griffinross2/Neo-GPS/Hardware/SD_Card_Logger/sd_card_logger.kicad_pcb

## KiCad design Hardware/SD_Card_Logger/sd_card_logger.kicad_pcb (2026-05-09)

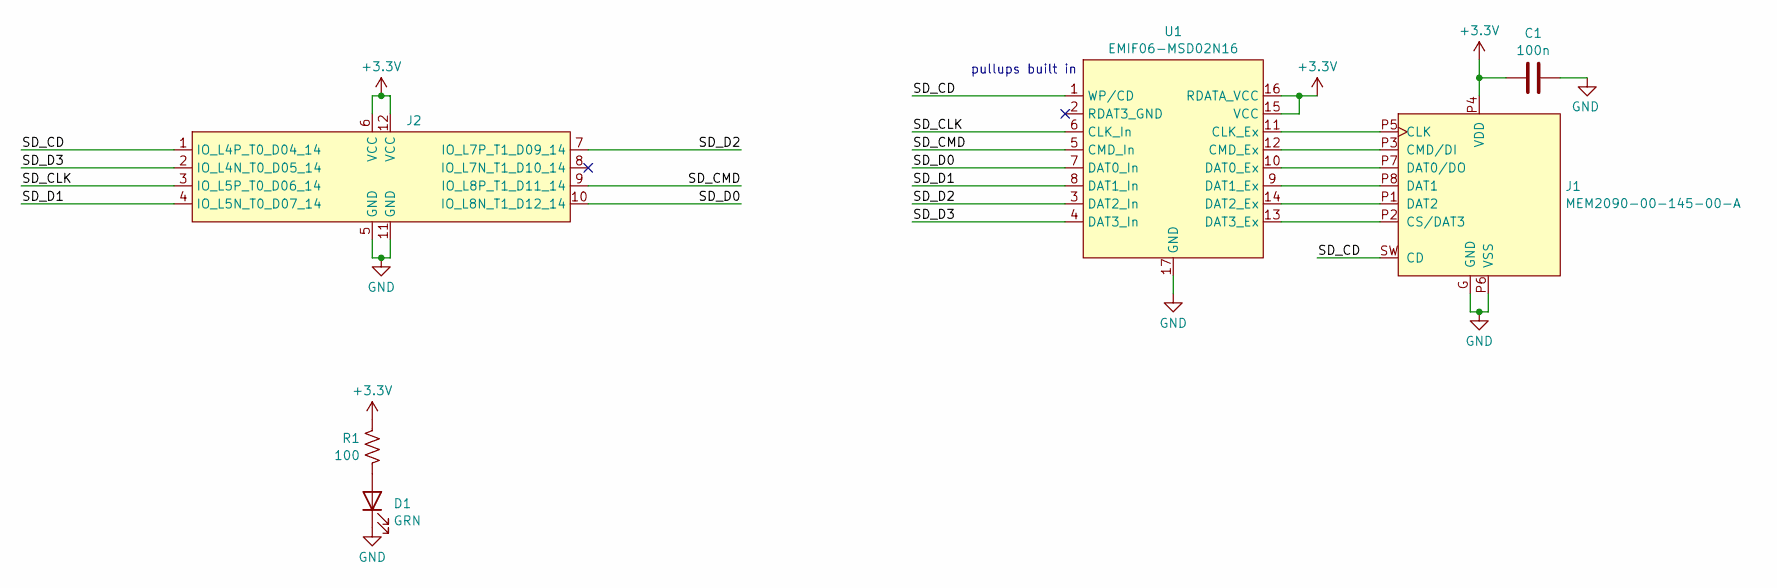
[picture p1: schematic sd_card_logger.kicad_sch]

Parts:
C1: 100n; C_0805_2012Metric; Manufacturer_Part_Number GCJ188R71H104KA12D
D1: GRN; LED_0805_2012Metric
J1: MEM2090-00-145-00-A; GCT_MEM2090-00-145-00-A_REVA; PARTREV A
J2: PinHeader_2x06_P2.54mm_Horizontal_Pmod
R1: 100; R_0805_2012Metric
U1: EMIF06-MSD02N16

Connections:
+3.3V: C1.1, J1.P4 (VDD), J2.6 (VCC), J2.12 (VCC), R1.1, U1.15 (VCC), U1.16 (RDATA_VCC)
/SD_CD: J1.SW (CD), J2.1 (IO_L4P_T0_D04_14), U1.1 (WP/CD)
/SD_CLK: J2.3 (IO_L5P_T0_D06_14), U1.6 (CLK_In)
/SD_CMD: J2.9 (IO_L8P_T1_D11_14), U1.5 (CMD_In)
/SD_D0: J2.10 (IO_L8N_T1_D12_14), U1.7 (DAT0_In)
/SD_D1: J2.4 (IO_L5N_T0_D07_14), U1.8 (DAT1_In)
/SD_D2: J2.7 (IO_L7P_T1_D09_14), U1.3 (DAT2_In)
/SD_D3: J2.2 (IO_L4N_T0_D05_14), U1.4 (DAT3_In)
GND: C1.2, D1.1 (K), J1.G (GND), J1.P6 (VSS), J2.5 (GND), J2.11 (GND), U1.17 (GND)
unnamed: D1.2 (A), R1.2
unnamed: J1.P5 (CLK), U1.11 (CLK_Ex)
unnamed: J1.P3 (CMD/DI), U1.12 (CMD_Ex)
unnamed: J1.P2 (CS/DAT3), U1.13 (DAT3_Ex)
unnamed: J1.P7 (DAT0/DO), U1.10 (DAT0_Ex)
unnamed: J1.P8 (DAT1), U1.9 (DAT1_Ex)
unnamed: J1.P1 (DAT2), U1.14 (DAT2_Ex)

Notes on the sheet:
pullups built in

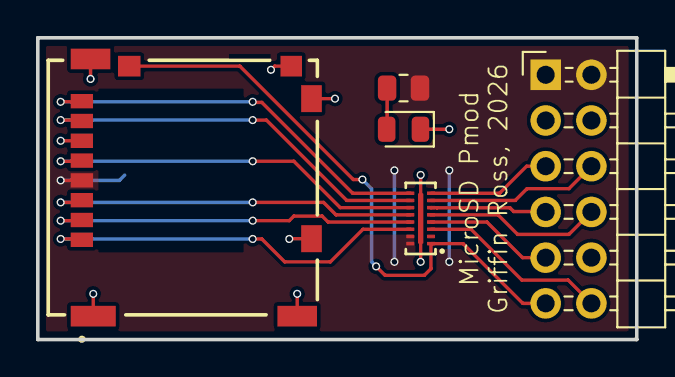
[picture p2: board sd_card_logger.kicad_pcb from above]

Board: 2 copper layers, 33.3 x 16.8 mm, 6 parts (1 on the bottom side), 16 nets.
