griffinross2/Neo-GPS/Hardware/GPS_Frontend/GPS_Frontend.kicad_pcb

## KiCad design Hardware/GPS_Frontend/GPS_Frontend.kicad_pcb (2026-05-03)

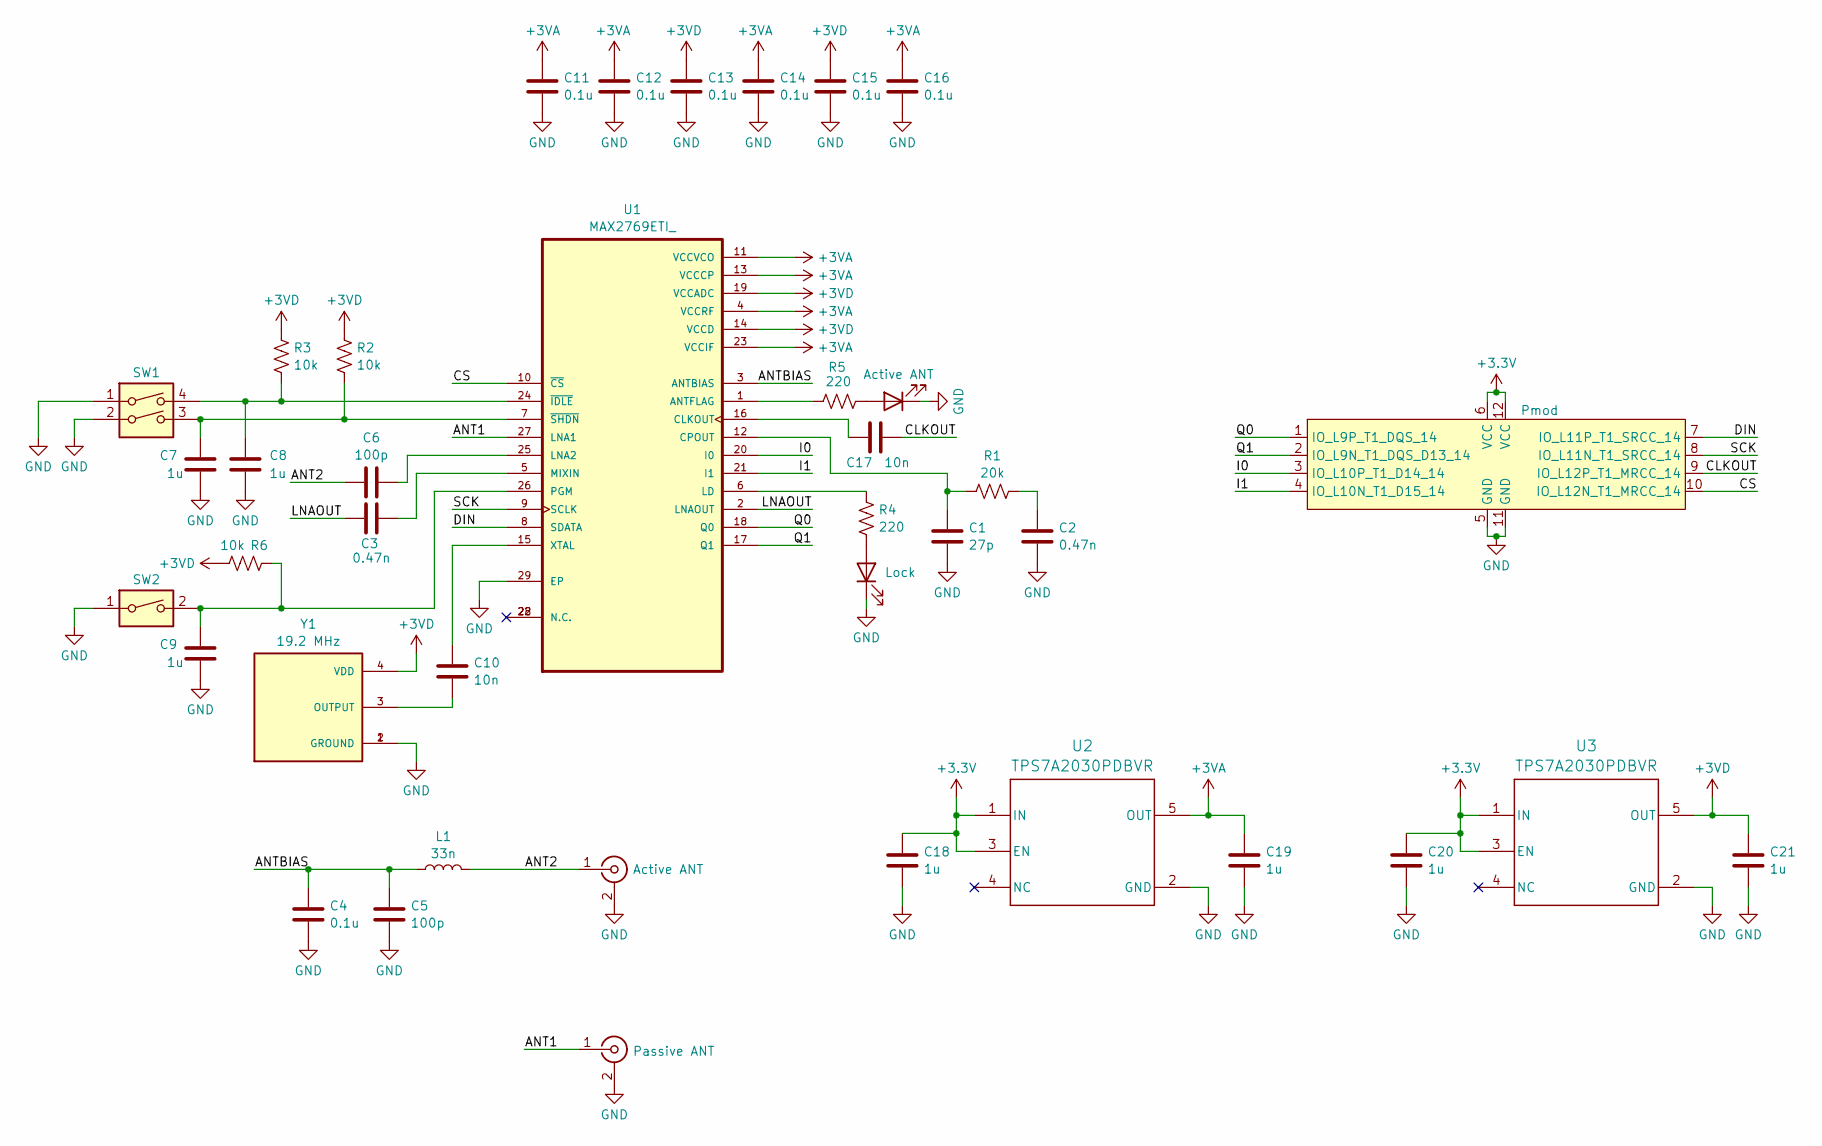
[picture p3: schematic GPS_Frontend.kicad_sch]

Parts:
C1: 27p; C_0402_1005Metric; Manufacturer_Part_Number GCM1555C1H270JA16J
C2, C3: 0.47n; C_0402_1005Metric; Manufacturer_Part_Number GCM1555C1H471JA16J
C4, C11, C12, C13, C14, C15, C16: 0.1u; C_0402_1005Metric; Manufacturer_Part_Number GRM155R61A104KA01J
C5, C6: 100p; C_0402_1005Metric; Manufacturer_Part_Number GRM1555C2A101GA01D
C7, C8, C9, C18, C19, C20, C21: 1u; C_0603_1608Metric; Manufacturer_Part_Number GRM188R61A105KA61J
C10, C17: 10n; C_0603_1608Metric; Manufacturer_Part_Number GCM188R72A103KA37D
J1: Pmod
J2: Passive ANT; SMA_Amphenol_132289_EdgeMount; Manufacturer_Part_Number 60312242114510
J3: Active ANT; SMA_Amphenol_132289_EdgeMount; Manufacturer_Part_Number 60312242114510
L1: 33n; L_0402_1005Metric; Manufacturer_Part_Number LQW15AN33NJ80D
LED1: Active ANT; LED_0805_2012Metric; Manufacturer_Part_Number 150080VS75000
LED2: Lock; LED_0805_2012Metric; Manufacturer_Part_Number 150080RS75000
R1: 20k; R_0603_1608Metric; Manufacturer_Part_Number RT0603FRE1020KL
R2, R3, R6: 10k; R_0603_1608Metric; Manufacturer_Part_Number RE0603FRE1310KL
R4, R5: 220; R_0603_1608Metric; Manufacturer_Part_Number RC0603JR-07220RP
SW1: SW_DIP_x02; SW_DIP_SPSTx02_Slide_6.7x6.64mm_W8.61mm_P2.54mm_LowProfile; Manufacturer_Part_Number A6S-2104-H
SW2: SW_DIP_x01; SW_DIP_SPSTx01_Slide_6.7x4.1mm_W8.61mm_P2.54mm_LowProfile; Manufacturer_Part_Number A6S-1104-H
U1: MAX2769ETI_; QFN50P500X500X80-29N
U2, U3: TPS7A2030PDBVR; DBV0005A-IPC_A
Y1: 19.2 MHz; OSC_ECS-TXO-20CSMV4-192-AN-TR; PARTREV N/A

Connections:
+3.3V: C18.1, C20.1, J1.6 (VCC), J1.12 (VCC), U2.1 (IN), U2.3 (EN), U3.1 (IN), U3.3 (EN)
+3VA: C11.1, C12.1, C14.1, C16.1, C19.1, U1.4 (VCCRF), U1.11 (VCCVCO), U1.13 (VCCCP), U1.23 (VCCIF), U2.5 (OUT)
+3VD: C13.1, C15.1, C21.1, R2.1, R3.1, R6.1, U1.14 (VCCD), U1.19 (VCCADC), U3.5 (OUT), Y1.4 (VDD)
/ANT1: J2.1 (In), U1.27 (LNA1)
/ANT2: C6.1, J3.1 (In), L1.2
/ANTBIAS: C4.1, C5.1, L1.1, U1.3 (ANTBIAS)
/CLKOUT: C17.2, J1.9 (IO_L12P_T1_MRCC_14)
/CS: J1.10 (IO_L12N_T1_MRCC_14), U1.10 (~CS)
/DIN: J1.7 (IO_L11P_T1_SRCC_14), U1.8 (SDATA)
/I0: J1.3 (IO_L10P_T1_D14_14), U1.20 (I0)
/I1: J1.4 (IO_L10N_T1_D15_14), U1.21 (I1)
/LNAOUT: C3.1, U1.2 (LNAOUT)
/Q0: J1.1 (IO_L9P_T1_DQS_14), U1.18 (Q0)
/Q1: J1.2 (IO_L9N_T1_DQS_D13_14), U1.17 (Q1)
/SCK: J1.8 (IO_L11N_T1_SRCC_14), U1.9 (SCLK)
GND: C1.2, C2.2, C4.2, C5.2, C7.2, C8.2, C9.2, C11.2, C12.2, C13.2, C14.2, C15.2, C16.2, C18.2, C19.2, C20.2, C21.2, J1.5 (GND), J1.11 (GND), J2.2 (Ext), J3.2 (Ext), LED1.1 (K), LED2.1 (K), SW1.1, SW1.2, SW2.1, U1.29 (EP), U2.2 (GND), U3.2 (GND), Y1.1 (GROUND), Y1.2 (GROUND)
unnamed: C2.1, R1.2
unnamed: LED1.2 (A), R5.1
unnamed: LED2.2 (A), R4.1
unnamed: R5.2, U1.1 (ANTFLAG)
unnamed: C17.1, U1.16 (CLKOUT)
unnamed: C1.1, R1.1, U1.12 (CPOUT)
unnamed: R4.2, U1.6 (LD)
unnamed: C6.2, U1.25 (LNA2)
unnamed: C3.2, U1.5 (MIXIN)
unnamed: C9.1, R6.2, SW2.2, U1.26 (PGM)
unnamed: C10.1, U1.15 (XTAL)
unnamed: C8.1, R3.2, SW1.4, U1.24 (~IDLE)
unnamed: C7.1, R2.2, SW1.3, U1.7 (~SHDN)
unnamed: C10.2, Y1.3 (OUTPUT)

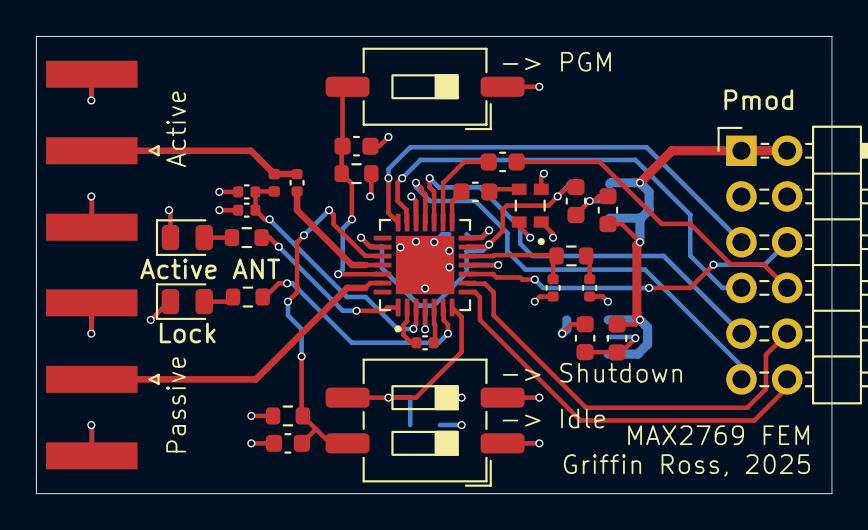
[picture p4: board GPS_Frontend.kicad_pcb from above]

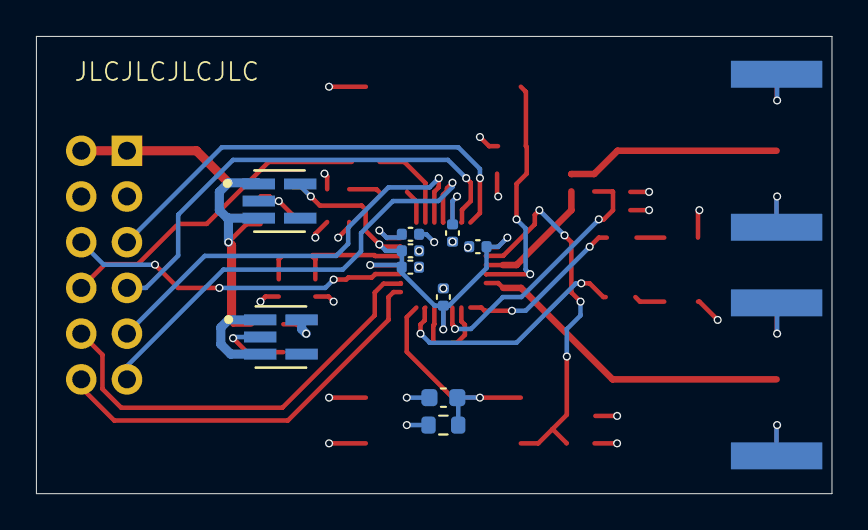
[picture p5: board GPS_Frontend.kicad_pcb from below]

Board: 4 copper layers, 44.2 x 25.4 mm, 39 parts (10 on the bottom side), 30 nets.
