griffinross2/Neo-GPS/RTL/constraints/Arty-S7-50-Master.xdc

## This file is a general .xdc for the Arty S7-50 Rev. B
## To use it in a project:
## - uncomment the lines corresponding to used pins
## - rename the used ports (in each line, after get_ports) according to the top level signal names in the project

## Clock signal
#set_property -dict { PACKAGE_PIN F14   IOSTANDARD LVCMOS33 } [get_ports { CLK12MHZ }]; #IO_L13P_T2_MRCC_15 Sch=uclk
#create_clock -add -name sys_clk_pin -period 83.333 -waveform {0 41.667} [get_ports { CLK12MHZ }];
set_property -dict {PACKAGE_PIN R2 IOSTANDARD SSTL135} [get_ports CLK]
create_clock -period 10.000 -name sys_clk_pin -waveform {0.000 5.000} -add [get_ports CLK]

# Switches
set_property -dict { PACKAGE_PIN H14   IOSTANDARD LVCMOS33 } [get_ports { SW[0] }]; #IO_L20N_T3_A19_15 Sch=sw[0]
set_property -dict { PACKAGE_PIN H18   IOSTANDARD LVCMOS33 } [get_ports { SW[1] }]; #IO_L21P_T3_DQS_15 Sch=sw[1]
set_property -dict { PACKAGE_PIN G18   IOSTANDARD LVCMOS33 } [get_ports { SW[2] }]; #IO_L21N_T3_DQS_A18_15 Sch=sw[2]
set_property -dict { PACKAGE_PIN M5    IOSTANDARD SSTL135 } [get_ports { SW[3] }]; #IO_L6N_T0_VREF_34 Sch=sw[3]


# RGB LEDs
set_property -dict { PACKAGE_PIN J15   IOSTANDARD LVCMOS33 } [get_ports { led0_r }]; #IO_L23N_T3_FWE_B_15 Sch=led0_r
set_property -dict { PACKAGE_PIN G17   IOSTANDARD LVCMOS33 } [get_ports { led0_g }]; #IO_L14N_T2_SRCC_15 Sch=led0_g
set_property -dict { PACKAGE_PIN F15   IOSTANDARD LVCMOS33 } [get_ports { led0_b }]; #IO_L13N_T2_MRCC_15 Sch=led0_b
set_property -dict { PACKAGE_PIN E15   IOSTANDARD LVCMOS33 } [get_ports { led1_r }]; #IO_L15N_T2_DQS_ADV_B_15 Sch=led1_r
set_property -dict { PACKAGE_PIN F18   IOSTANDARD LVCMOS33 } [get_ports { led1_g }]; #IO_L16P_T2_A28_15 Sch=led1_g
set_property -dict { PACKAGE_PIN E14   IOSTANDARD LVCMOS33 } [get_ports { led1_b }]; #IO_L15P_T2_DQS_15 Sch=led1_b


## LEDs
set_property -dict {PACKAGE_PIN E18 IOSTANDARD LVCMOS33} [get_ports {LED[0]}]
set_property -dict {PACKAGE_PIN F13 IOSTANDARD LVCMOS33} [get_ports {LED[1]}]
set_property -dict {PACKAGE_PIN E13 IOSTANDARD LVCMOS33} [get_ports {LED[2]}]
set_property -dict {PACKAGE_PIN H15 IOSTANDARD LVCMOS33} [get_ports {LED[3]}]


## Buttons
set_property -dict {PACKAGE_PIN G15 IOSTANDARD LVCMOS33} [get_ports {BTN[0]}]
set_property -dict {PACKAGE_PIN K16 IOSTANDARD LVCMOS33} [get_ports {BTN[1]}]
set_property -dict {PACKAGE_PIN J16 IOSTANDARD LVCMOS33} [get_ports {BTN[2]}]
set_property -dict {PACKAGE_PIN H13 IOSTANDARD LVCMOS33} [get_ports {BTN[3]}]


## PMOD Header JA
set_property -dict {PACKAGE_PIN L17 IOSTANDARD LVCMOS33} [get_ports ja_0]
set_property -dict {PACKAGE_PIN L18 IOSTANDARD LVCMOS33} [get_ports ja_1]
set_property -dict {PACKAGE_PIN M14 IOSTANDARD LVCMOS33} [get_ports ja_2]
set_property -dict {PACKAGE_PIN N14 IOSTANDARD LVCMOS33} [get_ports ja_3]
set_property -dict {PACKAGE_PIN M16 IOSTANDARD LVCMOS33} [get_ports ja_4]
set_property -dict { PACKAGE_PIN M17   IOSTANDARD LVCMOS33 } [get_ports { ja_5 }]; #IO_L7N_T1_D10_14 Sch=ja_n[3]
set_property -dict {PACKAGE_PIN M18 IOSTANDARD LVCMOS33} [get_ports ja_6]
set_property -dict {PACKAGE_PIN N18 IOSTANDARD LVCMOS33} [get_ports ja_7]


## PMOD Header JB
set_property -dict {PACKAGE_PIN P17 IOSTANDARD LVCMOS33} [get_ports jb_0]
set_property -dict {PACKAGE_PIN P18 IOSTANDARD LVCMOS33} [get_ports jb_1]
set_property -dict {PACKAGE_PIN R18 IOSTANDARD LVCMOS33} [get_ports jb_2]
set_property -dict {PACKAGE_PIN T18 IOSTANDARD LVCMOS33} [get_ports jb_3]
set_property -dict {PACKAGE_PIN P14 IOSTANDARD LVCMOS33} [get_ports jb_4]
set_property -dict {PACKAGE_PIN P15 IOSTANDARD LVCMOS33} [get_ports jb_5]
set_property -dict {PACKAGE_PIN N15 IOSTANDARD LVCMOS33} [get_ports jb_6]
set_property -dict {PACKAGE_PIN P16 IOSTANDARD LVCMOS33} [get_ports jb_7]
create_clock -period 52.080 -name gnss_clk_pin -waveform {0.000 26.040} -add [get_ports jb_6]


## PMOD Header JC
#set_property -dict { PACKAGE_PIN U15   IOSTANDARD LVCMOS33 } [get_ports { jc[0] }]; #IO_L18P_T2_A12_D28_14 Sch=jc1/ck_io[41]
#set_property -dict { PACKAGE_PIN V16   IOSTANDARD LVCMOS33 } [get_ports { jc[1] }]; #IO_L18N_T2_A11_D27_14 Sch=jc2/ck_io[40]
#set_property -dict { PACKAGE_PIN U17   IOSTANDARD LVCMOS33 } [get_ports { jc[2] }]; #IO_L15P_T2_DQS_RDWR_B_14 Sch=jc3/ck_io[39]
#set_property -dict { PACKAGE_PIN U18   IOSTANDARD LVCMOS33 } [get_ports { jc[3] }]; #IO_L15N_T2_DQS_DOUT_CSO_B_14 Sch=jc4/ck_io[38]
#set_property -dict { PACKAGE_PIN U16   IOSTANDARD LVCMOS33 } [get_ports { jc[4] }]; #IO_L16P_T2_CSI_B_14 Sch=jc7/ck_io[37]
#set_property -dict { PACKAGE_PIN P13   IOSTANDARD LVCMOS33 } [get_ports { jc[5] }]; #IO_L19P_T3_A10_D26_14 Sch=jc8/ck_io[36]
#set_property -dict { PACKAGE_PIN R13   IOSTANDARD LVCMOS33 } [get_ports { jc[6] }]; #IO_L19N_T3_A09_D25_VREF_14 Sch=jc9/ck_io[35]
#set_property -dict { PACKAGE_PIN V14   IOSTANDARD LVCMOS33 } [get_ports { jc[7] }]; #IO_L20P_T3_A08_D24_14 Sch=jc10/ck_io[34]


## PMOD Header JD
#set_property -dict { PACKAGE_PIN V15   IOSTANDARD LVCMOS33 } [get_ports { jd[0] }]; #IO_L20N_T3_A07_D23_14 Sch=jd1/ck_io[33]
#set_property -dict { PACKAGE_PIN U12   IOSTANDARD LVCMOS33 } [get_ports { jd[1] }]; #IO_L21P_T3_DQS_14 Sch=jd2/ck_io[32]
#set_property -dict { PACKAGE_PIN V13   IOSTANDARD LVCMOS33 } [get_ports { jd[2] }]; #IO_L21N_T3_DQS_A06_D22_14 Sch=jd3/ck_io[31]
#set_property -dict { PACKAGE_PIN T12   IOSTANDARD LVCMOS33 } [get_ports { jd[3] }]; #IO_L22P_T3_A05_D21_14 Sch=jd4/ck_io[30]
#set_property -dict { PACKAGE_PIN T13   IOSTANDARD LVCMOS33 } [get_ports { jd[4] }]; #IO_L22N_T3_A04_D20_14 Sch=jd7/ck_io[29]
#set_property -dict { PACKAGE_PIN R11   IOSTANDARD LVCMOS33 } [get_ports { jd[5] }]; #IO_L23P_T3_A03_D19_14 Sch=jd8/ck_io[28]
#set_property -dict { PACKAGE_PIN T11   IOSTANDARD LVCMOS33 } [get_ports { jd[6] }]; #IO_L23N_T3_A02_D18_14 Sch=jd9/ck_io[27]
#set_property -dict { PACKAGE_PIN U11   IOSTANDARD LVCMOS33 } [get_ports { jd[7] }]; #IO_L24P_T3_A01_D17_14 Sch=jd10/ck_io[26]


## USB-UART Interface
set_property -dict {PACKAGE_PIN R12 IOSTANDARD LVCMOS33} [get_ports UART_TXD]
set_property -dict {PACKAGE_PIN V12 IOSTANDARD LVCMOS33} [get_ports uart_txd_in]


## ChipKit Single Ended Analog Inputs
## NOTE: The ck_an_p pins can be used as single ended analog inputs with voltages from 0-3.3V (Chipkit Analog pins A0-A5).
## These signals should only be connected to the XADC core. When using these pins as digital I/O, use pins ck_io[14-19].
#set_property -dict { PACKAGE_PIN B13   IOSTANDARD LVCMOS33 } [get_ports { Vaux0_v_p }]; #IO_L1P_T0_AD0P_15 Sch=ck_an_p[0]
#set_property -dict { PACKAGE_PIN A13   IOSTANDARD LVCMOS33 } [get_ports { Vaux0_v_n }]; #IO_L1N_T0_AD0N_15 Sch=ck_an_n[0]
#set_property -dict { PACKAGE_PIN B15   IOSTANDARD LVCMOS33 } [get_ports { Vaux1_v_p }]; #IO_L3P_T0_DQS_AD1P_15 Sch=ck_an_p[1]
#set_property -dict { PACKAGE_PIN A15   IOSTANDARD LVCMOS33 } [get_ports { Vaux1_v_n }]; #IO_L3N_T0_DQS_AD1N_15 Sch=ck_an_n[1]
#set_property -dict { PACKAGE_PIN E12   IOSTANDARD LVCMOS33 } [get_ports { Vaux9_v_p }]; #IO_L5P_T0_AD9P_15 Sch=ck_an_p[2]
#set_property -dict { PACKAGE_PIN D12   IOSTANDARD LVCMOS33 } [get_ports { Vaux9_v_n }]; #IO_L5N_T0_AD9N_15 Sch=ck_an_n[2]
#set_property -dict { PACKAGE_PIN B17   IOSTANDARD LVCMOS33 } [get_ports { Vaux2_v_p }]; #IO_L7P_T1_AD2P_15 Sch=ck_an_p[3]
#set_property -dict { PACKAGE_PIN A17   IOSTANDARD LVCMOS33 } [get_ports { Vaux2_v_n }]; #IO_L7N_T1_AD2N_15 Sch=ck_an_n[3]
#set_property -dict { PACKAGE_PIN C17   IOSTANDARD LVCMOS33 } [get_ports { Vaux10_v_p }]; #IO_L8P_T1_AD10P_15 Sch=ck_an_p[4]
#set_property -dict { PACKAGE_PIN B18   IOSTANDARD LVCMOS33 } [get_ports { Vaux10_v_n }]; #IO_L8N_T1_AD10N_15 Sch=ck_an_n[4]
#set_property -dict { PACKAGE_PIN E16   IOSTANDARD LVCMOS33 } [get_ports { Vaux11_v_p }]; #IO_L10P_T1_AD11P_15 Sch=ck_an_p[5]
#set_property -dict { PACKAGE_PIN E17   IOSTANDARD LVCMOS33 } [get_ports { Vaux11_v_n }]; #IO_L10N_T1_AD11N_15 Sch=ck_an_n[5]

## Dedicated Analog Inputs
#set_property -dict { PACKAGE_PIN J10   } [get_ports { Vp_Vn_v_p }]; #IO_L1P_T0_AD4P_35 Sch=v_p
#set_property -dict { PACKAGE_PIN K9    } [get_ports { Vp_Vn_v_n }]; #IO_L1N_T0_AD4N_35 Sch=v_n


## ChipKit Digital I/O Low
#set_property -dict { PACKAGE_PIN L13   IOSTANDARD LVCMOS33 } [get_ports { ck_io[0] }]; #IO_0_14 Sch=ck_io[0]
#set_property -dict { PACKAGE_PIN N13   IOSTANDARD LVCMOS33 } [get_ports { ck_io[1] }]; #IO_L6N_T0_D08_VREF_14 Sch=ck_io[1]
#set_property -dict { PACKAGE_PIN L16   IOSTANDARD LVCMOS33 } [get_ports { ck_io[2] }]; #IO_L3N_T0_DQS_EMCCLK_14 Sch=ck_io[2]
set_property -dict {PACKAGE_PIN R14 IOSTANDARD LVCMOS33} [get_ports ck_io3]; #IO_L13P_T2_MRCC_14      Sch=ck_io[3], MCU IF CLK
set_property -dict {PACKAGE_PIN T14 IOSTANDARD LVCMOS33} [get_ports ck_io4]; #IO_L13N_T2_MRCC_14      Sch=ck_io[4], MCU IF CS
set_property -dict { PACKAGE_PIN R16   IOSTANDARD LVCMOS33 } [get_ports ck_io5]; #IO_L14P_T2_SRCC_14      Sch=ck_io[5]
#set_property -dict { PACKAGE_PIN R17   IOSTANDARD LVCMOS33 } [get_ports { ck_io6 }]; #IO_L14N_T2_SRCC_14      Sch=ck_io[6]
#set_property -dict { PACKAGE_PIN V17   IOSTANDARD LVCMOS33 } [get_ports { ck_io[7] }]; #IO_L16N_T2_A15_D31_14 Sch=ck_io[7]
#set_property -dict { PACKAGE_PIN R15   IOSTANDARD LVCMOS33 } [get_ports { ck_io[8] }]; #IO_L17P_T2_A14_D30_14 Sch=ck_io[8]
#set_property -dict { PACKAGE_PIN T15   IOSTANDARD LVCMOS33 } [get_ports { ck_io[9] }]; #IO_L17N_T2_A13_D29_14 Sch=ck_io[9]
#set_property -dict { PACKAGE_PIN H16   IOSTANDARD LVCMOS33 } [get_ports { ck_io[10] }]; #IO_L22P_T3_A17_15 Sch=ck_io10_ss
#set_property -dict { PACKAGE_PIN H17   IOSTANDARD LVCMOS33 } [get_ports { ck_io[11] }]; #IO_L22N_T3_A16_15 Sch=ck_io11_mosi
#set_property -dict { PACKAGE_PIN K14   IOSTANDARD LVCMOS33 } [get_ports { ck_io[12] }]; #IO_L23P_T3_FOE_B_15 Sch=ck_io12_miso
#set_property -dict { PACKAGE_PIN G16   IOSTANDARD LVCMOS33 } [get_ports { ck_io[13] }]; #IO_L14P_T2_SRCC_15 Sch=ck_io13_sck


## ChipKit Digital I/O On Outer Analog Header
## NOTE: These pins should be used when using the analog header signals A0-A5 as digital I/O (Chipkit digital pins 14-19)
#set_property -dict { PACKAGE_PIN G13   IOSTANDARD LVCMOS33 } [get_ports { ck_io[14] }]; #IO_0_15 Sch=ck_a[0]
#set_property -dict { PACKAGE_PIN B16   IOSTANDARD LVCMOS33 } [get_ports { ck_io[15] }]; #IO_L4P_T0_15 Sch=ck_a[1]
#set_property -dict { PACKAGE_PIN A16   IOSTANDARD LVCMOS33 } [get_ports { ck_io[16] }]; #IO_L4N_T0_15 Sch=ck_a[2]
#set_property -dict { PACKAGE_PIN C13   IOSTANDARD LVCMOS33 } [get_ports { ck_io[17] }]; #IO_L6P_T0_15 Sch=ck_a[3]
#set_property -dict { PACKAGE_PIN C14   IOSTANDARD LVCMOS33 } [get_ports { ck_io[18] }]; #IO_L6N_T0_VREF_15 Sch=ck_a[4]
#set_property -dict { PACKAGE_PIN D18   IOSTANDARD LVCMOS33 } [get_ports { ck_io[19] }]; #IO_L11P_T1_SRCC_15 Sch=ck_a[5]


## ChipKit Digital I/O On Inner Analog Header
## NOTE: These pins will need to be connected to the XADC core when used as differential analog inputs (Chipkit analog pins A6-A11)
#set_property -dict { PACKAGE_PIN B14   IOSTANDARD LVCMOS33 } [get_ports { ck_io[20] }]; #IO_L2P_T0_AD8P_15 Sch=ad_p[8]
#set_property -dict { PACKAGE_PIN A14   IOSTANDARD LVCMOS33 } [get_ports { ck_io[21] }]; #IO_L2N_T0_AD8N_15 Sch=ad_n[8]
#set_property -dict { PACKAGE_PIN D16   IOSTANDARD LVCMOS33 } [get_ports { ck_io[22] }]; #IO_L9P_T1_DQS_AD3P_15 Sch=ad_p[3]
#set_property -dict { PACKAGE_PIN D17   IOSTANDARD LVCMOS33 } [get_ports { ck_io[23] }]; #IO_L9N_T1_DQS_AD3N_15 Sch=ad_n[3]
#set_property -dict { PACKAGE_PIN D14   IOSTANDARD LVCMOS33 } [get_ports { ck_io[24] }]; #IO_L12P_T1_MRCC_15 Sch=ck_a10_r
#set_property -dict { PACKAGE_PIN D15   IOSTANDARD LVCMOS33 } [get_ports { ck_io[25] }]; #IO_L12N_T1_MRCC_15 Sch=ck_a11_r


## ChipKit Digital I/O High
## Note: these pins are shared with PMOD Headers JC and JD and cannot be used at the same time as the applicable PMOD interface(s)
set_property -dict { PACKAGE_PIN U11   IOSTANDARD LVCMOS33 } [get_ports ck_io26]; #IO_L24P_T3_A01_D17_14 Sch=jd10/ck_io[26],        MCU IF D0
set_property -dict { PACKAGE_PIN T11   IOSTANDARD LVCMOS33 } [get_ports ck_io27]; #IO_L23N_T3_A02_D18_14 Sch=jd9/ck_io[27],         MCU IF D1
set_property -dict { PACKAGE_PIN R11   IOSTANDARD LVCMOS33 } [get_ports ck_io28]; #IO_L23P_T3_A03_D19_14 Sch=jd8/ck_io[28],         MCU IF D2
set_property -dict { PACKAGE_PIN T13   IOSTANDARD LVCMOS33 } [get_ports ck_io29]; #IO_L22N_T3_A04_D20_14 Sch=jd7/ck_io[29],         MCU IF D3
set_property -dict { PACKAGE_PIN T12   IOSTANDARD LVCMOS33 } [get_ports ck_io30]; #IO_L22P_T3_A05_D21_14 Sch=jd4/ck_io[30],         MCU IF D4
set_property -dict { PACKAGE_PIN V13   IOSTANDARD LVCMOS33 } [get_ports ck_io31]; #IO_L21N_T3_DQS_A06_D22_14 Sch=jd3/ck_io[31],     MCU IF D5
set_property -dict { PACKAGE_PIN U12   IOSTANDARD LVCMOS33 } [get_ports ck_io32]; #IO_L21P_T3_DQS_14 Sch=jd2/ck_io[32],             MCU IF D6
set_property -dict { PACKAGE_PIN V15   IOSTANDARD LVCMOS33 } [get_ports ck_io33]; #IO_L20N_T3_A07_D23_14 Sch=jd1/ck_io[33],         MCU IF D7
set_property -dict { PACKAGE_PIN V14   IOSTANDARD LVCMOS33 } [get_ports ck_io34]; #IO_L20P_T3_A08_D24_14 Sch=jc10/ck_io[34],        MCU IF D8
set_property -dict { PACKAGE_PIN R13   IOSTANDARD LVCMOS33 } [get_ports ck_io35]; #IO_L19N_T3_A09_D25_VREF_14 Sch=jc9/ck_io[35],    MCU IF D9
set_property -dict { PACKAGE_PIN P13   IOSTANDARD LVCMOS33 } [get_ports ck_io36]; #IO_L19P_T3_A10_D26_14 Sch=jc8/ck_io[36],         MCU IF D10
set_property -dict { PACKAGE_PIN U16   IOSTANDARD LVCMOS33 } [get_ports ck_io37]; #IO_L16P_T2_CSI_B_14 Sch=jc7/ck_io[37],           MCU IF D11
set_property -dict { PACKAGE_PIN U18   IOSTANDARD LVCMOS33 } [get_ports ck_io38]; #IO_L15N_T2_DQS_DOUT_CSO_B_14 Sch=jc4/ck_io[38],  MCU IF D12
set_property -dict { PACKAGE_PIN U17   IOSTANDARD LVCMOS33 } [get_ports ck_io39]; #IO_L15P_T2_DQS_RDWR_B_14 Sch=jc3/ck_io[39],      MCU IF D13
set_property -dict { PACKAGE_PIN V16   IOSTANDARD LVCMOS33 } [get_ports ck_io40]; #IO_L18N_T2_A11_D27_14 Sch=jc2/ck_io[40],         MCU IF D14
set_property -dict { PACKAGE_PIN U15   IOSTANDARD LVCMOS33 } [get_ports ck_io41]; #IO_L18P_T2_A12_D28_14 Sch=jc1/ck_io[41],         MCU IF D15


## ChipKit SPI
## Note: these are shared with the ChipKit IOL pins and should not be used at the same time as the pins.
#set_property -dict { PACKAGE_PIN H16   IOSTANDARD LVCMOS33 } [get_ports { ck_ss }]; #IO_L22P_T3_A17_15 Sch=ck_io10_ss
#set_property -dict { PACKAGE_PIN H17   IOSTANDARD LVCMOS33 } [get_ports { ck_mosi }]; #IO_L22N_T3_A16_15 Sch=ck_io11_mosi
#set_property -dict { PACKAGE_PIN K14   IOSTANDARD LVCMOS33 } [get_ports { ck_miso }]; #IO_L23P_T3_FOE_B_15 Sch=ck_io12_miso
#set_property -dict { PACKAGE_PIN G16   IOSTANDARD LVCMOS33 } [get_ports { ck_sck }]; #IO_L14P_T2_SRCC_15 Sch=ck_io13_sck


## CihpKit I2C
#set_property -dict { PACKAGE_PIN J14   IOSTANDARD LVCMOS33 } [get_ports { ck_scl }]; #IO_L24N_T3_RS0_15 Sch=ck_scl
#set_property -dict { PACKAGE_PIN J13   IOSTANDARD LVCMOS33 } [get_ports { ck_sda }]; #IO_L24P_T3_RS1_15 Sch=ck_sda


## Misc. ChipKit signals
#set_property -dict { PACKAGE_PIN K13   IOSTANDARD LVCMOS33 } [get_ports { ck_ioa }]; #IO_25_15 Sch=ck_ioa
set_property -dict {PACKAGE_PIN C18 IOSTANDARD LVCMOS33} [get_ports ck_rst]


## Quad SPI Flash
## Note: the SCK clock signal can be driven using the STARTUPE2 primitive
set_property -dict { PACKAGE_PIN M13   IOSTANDARD LVCMOS33 } [get_ports { qspi_cs }]; #IO_L6P_T0_FCS_B_14 Sch=qspi_cs
set_property -dict { PACKAGE_PIN K17   IOSTANDARD LVCMOS33 } [get_ports { qspi_dq[0] }]; #IO_L1P_T0_D00_MOSI_14 Sch=qspi_dq[0]
set_property -dict { PACKAGE_PIN K18   IOSTANDARD LVCMOS33 } [get_ports { qspi_dq[1] }]; #IO_L1N_T0_D01_DIN_14 Sch=qspi_dq[1]
set_property -dict { PACKAGE_PIN L14   IOSTANDARD LVCMOS33 } [get_ports { qspi_dq[2] }]; #IO_L2P_T0_D02_14 Sch=qspi_dq[2]
set_property -dict { PACKAGE_PIN M15   IOSTANDARD LVCMOS33 } [get_ports { qspi_dq[3] }]; #IO_L2N_T0_D03_14 Sch=qspi_dq[3]

## Configuration options, can be used for all designs
set_property BITSTREAM.CONFIG.CONFIGRATE 50 [current_design]
set_property CONFIG_VOLTAGE 3.3 [current_design]
set_property CFGBVS VCCO [current_design]
set_property BITSTREAM.CONFIG.SPI_BUSWIDTH 4 [current_design]
set_property CONFIG_MODE SPIx4 [current_design]

## SW3 is assigned to a pin M5 in the 1.35v bank. This pin can also be used as
## the VREF for BANK 34. To ensure that SW3 does not define the reference voltage
## and to be able to use this pin as an ordinary I/O the following property must
## be set to enable an internal VREF for BANK 34. Since a 1.35v supply is being
## used the internal reference is set to half that value (i.e. 0.675v). Note that
## this property must be set even if SW3 is not used in the design.
set_property INTERNAL_VREF 0.675 [get_iobanks 34]

# create_debug_core u_ila_0 ila
# set_property ALL_PROBE_SAME_MU true [get_debug_cores u_ila_0]
# set_property ALL_PROBE_SAME_MU_CNT 1 [get_debug_cores u_ila_0]
# set_property C_ADV_TRIGGER false [get_debug_cores u_ila_0]
# set_property C_DATA_DEPTH 1024 [get_debug_cores u_ila_0]
# set_property C_EN_STRG_QUAL false [get_debug_cores u_ila_0]
# set_property C_INPUT_PIPE_STAGES 0 [get_debug_cores u_ila_0]
# set_property C_TRIGIN_EN false [get_debug_cores u_ila_0]
# set_property C_TRIGOUT_EN false [get_debug_cores u_ila_0]
# set_property port_width 1 [get_debug_ports u_ila_0/clk]
# connect_debug_port u_ila_0/clk [get_nets [list CLK_IBUF_BUFG]]
# set_property PROBE_TYPE DATA [get_debug_ports u_ila_0/probe0]
# set_property port_width 32 [get_debug_ports u_ila_0/probe0]
# connect_debug_port u_ila_0/probe0 [get_nets [list {system_inst/cpu_inst/datapath_inst/pc[0]} {system_inst/cpu_inst/datapath_inst/pc[1]} {system_inst/cpu_inst/datapath_inst/pc[2]} {system_inst/cpu_inst/datapath_inst/pc[3]} {system_inst/cpu_inst/datapath_inst/pc[4]} {system_inst/cpu_inst/datapath_inst/pc[5]} {system_inst/cpu_inst/datapath_inst/pc[6]} {system_inst/cpu_inst/datapath_inst/pc[7]} {system_inst/cpu_inst/datapath_inst/pc[8]} {system_inst/cpu_inst/datapath_inst/pc[9]} {system_inst/cpu_inst/datapath_inst/pc[10]} {system_inst/cpu_inst/datapath_inst/pc[11]} {system_inst/cpu_inst/datapath_inst/pc[12]} {system_inst/cpu_inst/datapath_inst/pc[13]} {system_inst/cpu_inst/datapath_inst/pc[14]} {system_inst/cpu_inst/datapath_inst/pc[15]} {system_inst/cpu_inst/datapath_inst/pc[16]} {system_inst/cpu_inst/datapath_inst/pc[17]} {system_inst/cpu_inst/datapath_inst/pc[18]} {system_inst/cpu_inst/datapath_inst/pc[19]} {system_inst/cpu_inst/datapath_inst/pc[20]} {system_inst/cpu_inst/datapath_inst/pc[21]} {system_inst/cpu_inst/datapath_inst/pc[22]} {system_inst/cpu_inst/datapath_inst/pc[23]} {system_inst/cpu_inst/datapath_inst/pc[24]} {system_inst/cpu_inst/datapath_inst/pc[25]} {system_inst/cpu_inst/datapath_inst/pc[26]} {system_inst/cpu_inst/datapath_inst/pc[27]} {system_inst/cpu_inst/datapath_inst/pc[28]} {system_inst/cpu_inst/datapath_inst/pc[29]} {system_inst/cpu_inst/datapath_inst/pc[30]} {system_inst/cpu_inst/datapath_inst/pc[31]}]]
# create_debug_port u_ila_0 probe
# set_property PROBE_TYPE DATA_AND_TRIGGER [get_debug_ports u_ila_0/probe1]
# set_property port_width 1 [get_debug_ports u_ila_0/probe1]
# connect_debug_port u_ila_0/probe1 [get_nets [list cpuclk]]
# set_property C_CLK_INPUT_FREQ_HZ 300000000 [get_debug_cores dbg_hub]
# set_property C_ENABLE_CLK_DIVIDER false [get_debug_cores dbg_hub]
# set_property C_USER_SCAN_CHAIN 1 [get_debug_cores dbg_hub]
# connect_debug_port dbg_hub/clk [get_nets CLK_IBUF_BUFG]

create_clock -period 20.000 -name core_clk -waveform {0.000 10.000} [get_nets core_clk]
create_clock -period 200.000 -name mcu_sck -waveform {0.000 100.000} [get_nets ck_io3]
