griffinross2/Neo-GPS/RTL/testbench/uart/uart_rx_tb.sv

`timescale 1ns/1ns

module uart_rx_tb (
);
    logic clk, nrst, nrst_gen;
    logic [7:0] data;
    logic [7:0] rx_data;
    logic start;
    logic serial_out;
    logic tx_done;
    logic rx_done;
    logic tx_busy;
    logic rx_busy;

    localparam logic[15:0] BIT_PERIOD = 10417; // Bit period in clk cycles

    uart_tx tx (
        .clk(clk),
        .nrst(nrst),
        .bit_period(BIT_PERIOD),
        .data(data),
        .start(start),
        .serial_out(serial_out),
        .tx_done(tx_done),
        .tx_busy(tx_busy)
    );

    uart_rx dut (
        .clk(clk),
        .nrst(nrst),
        .bit_period(BIT_PERIOD),
        .data(rx_data),
        .serial_in(serial_out),
        .rx_done(rx_done),
        .rx_busy(rx_busy)
    );

    test PROG (
        .clk(clk),
        .serial_out(serial_out),
        .tx_done(tx_done),
        .rx_data(rx_data),
        .nrst_gen(nrst_gen),
        .data(data),
        .start(start)
    );

    // Clock generation
    initial begin
        clk = 0;
        forever #5 clk = ~clk;
    end

    // Reset generation
    assign nrst = nrst_gen;

    assign start = 1'b1;

endmodule

program test (input logic clk, input logic serial_out, input logic tx_done, input logic [7:0] rx_data, output logic nrst_gen, output logic [7:0] data, output logic start);
    string test_name = "";

    task reset_dut();
        data = 8'h00;
        start = 0;

        nrst_gen = 0;
        @(posedge clk);
        @(posedge clk);
        nrst_gen = 1;
        @(posedge clk);
    endtask

    task send_data(input logic [7:0] data_in);
        data = data_in;
        start = 1;
        wait(~tx_done);
        wait(tx_done);
        start = 0;
        @(posedge clk);
    endtask

    task receive_data();
        $display("Received data: %h", rx_data);
    endtask
        
    initial begin
        test_name = "UART TX Test";
        
        // Reset the DUT
        reset_dut();

        // Send data
        send_data(8'hA5);
        receive_data();
        
        send_data(8'h1F);
        receive_data();

        send_data(8'h00);
        receive_data();

        send_data(8'hFF);
        receive_data();

        $display("%s completed successfully", test_name);

        $finish;
    end

endprogram
