griffinross2/Neo-GPS/Simulation/inc/e1_code.h

#pragma once

#pragma once

#include <stdint.h>
#include <array>

// Values from Galileo OS SIS ICD v2.2

constexpr uint8_t E1B_PRIMARY_CODE[50][512] = {
    {0xF5, 0xD7, 0x10, 0x13, 0x05, 0x73, 0x54, 0x1B, 0x9D, 0xBD, 0x4F, 0xD9, 0xE9, 0xB2, 0x0A, 0x0D, 0x59, 0xD1, 0x44,
     0xC5, 0x4B, 0xC7, 0x93, 0x55, 0x39, 0xD2, 0xE7, 0x58, 0x10, 0xFB, 0x51, 0xE4, 0x94, 0x09, 0x3A, 0x0A, 0x19, 0xDD,
     0x79, 0xC7, 0x0C, 0x5A, 0x98, 0xE5, 0x65, 0x7A, 0xA5, 0x78, 0x09, 0x77, 0x77, 0xE8, 0x6B, 0xCC, 0x46, 0x51, 0xCC,
     0x72, 0xF2, 0xF9, 0x74, 0xDC, 0x76, 0x6E, 0x07, 0xAE, 0xA3, 0xD0, 0xB5, 0x57, 0xEF, 0x42, 0xFF, 0x57, 0xE6, 0xA5,
     0x8E, 0x80, 0x53, 0x58, 0xCE, 0x92, 0x57, 0x66, 0x91, 0x33, 0xB1, 0x8F, 0x80, 0xFD, 0xBD, 0xFB, 0x38, 0xC5, 0x52,
     0x4C, 0x7F, 0xB1, 0xDE, 0x07, 0x98, 0x42, 0x48, 0x29, 0x90, 0xDF, 0x58, 0xF7, 0x23, 0x21, 0xD9, 0x20, 0x1F, 0x89,
     0x79, 0xEA, 0xB1, 0x59, 0xB2, 0x67, 0x9C, 0x9E, 0x95, 0xAA, 0x6D, 0x53, 0x45, 0x6C, 0x0D, 0xF7, 0x5C, 0x2B, 0x43,
     0x16, 0xD1, 0xE2, 0x30, 0x92, 0x16, 0x88, 0x28, 0x54, 0x25, 0x3A, 0x1F, 0xA6, 0x0C, 0xA2, 0xC9, 0x4E, 0xCE, 0x01,
     0x3E, 0x2A, 0x8C, 0x94, 0x33, 0x41, 0xE7, 0xD9, 0xE5, 0xA8, 0x46, 0x4B, 0x3A, 0xD4, 0x07, 0xE0, 0xAE, 0x46, 0x5C,
     0x3E, 0x3D, 0xD1, 0xBE, 0x60, 0xA8, 0xC3, 0xD5, 0x0F, 0x83, 0x15, 0x36, 0x40, 0x1E, 0x77, 0x6B, 0xE0, 0x2A, 0x60,
     0x42, 0xFC, 0x4A, 0x27, 0xAF, 0x65, 0x3F, 0x0C, 0xFC, 0x4D, 0x4D, 0x01, 0x3F, 0x11, 0x53, 0x10, 0x78, 0x8D, 0x68,
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
};

class E1Code
{
public:
    E1Code() = default;
    E1Code(int sv, int chip_start = 0);

    void clock_chip();
    int get_chip_b();
    int get_chip_c();
    void set_chip(int chip);

    int chip;

private:
    int m_sv;
    uint8_t m_current_byte_b;
    uint8_t m_current_byte_c;
};
