griffinross2/Neo-GPS/RTL/verilator/gps_tb/sim_main.cpp

// Include common routines
#include <verilated.h>
#include <verilated_fst_c.h>
#include <iostream>
#include <string>
#include <format>
#include <csignal>

// Include model header, generated from Verilating "top.v"
#include "Vgps_tb.h"

#include "sim_sched.h"
#include "parallel_interface_host.h"
#include "test_program.h"

double sc_time_stamp()
{
    return 0;
}

bool killed = false;

void sigint_handler(int signal)
{
    killed = true;
}

int main(int argc, char **argv)
{
    std::signal(SIGINT, sigint_handler);
    // See a similar example walkthrough in the verilator manpage.

    // This is intended to be a minimal example.  Before copying this to start a
    // real project, it is better to start with a more complete example,
    // e.g. examples/c_tracing.

    // Construct a VerilatedContext to hold simulation time, etc.
    VerilatedContext *const contextp = new VerilatedContext;

    // Pass arguments so Verilated code can see them, e.g. $value$plusargs
    // This needs to be called before you create any model
    contextp->commandArgs(argc, argv);

    contextp->traceEverOn(true);
    contextp->threads(1);

    VerilatedFstC *tfp = new VerilatedFstC;
    tfp->set_time_unit("ns");
    tfp->set_time_resolution("ns");

    // Construct the Verilated model, from Vtop.h generated from Verilating "top.v"
    Vgps_tb *const top = new Vgps_tb{contextp};

    int main_time = 0;
    std::string outpath = std::format("outputs/gps_tb/waveform{}.fst", main_time);
    top->trace(tfp, 99);
    tfp->open(outpath.c_str());

    test_program_init(contextp, top);

    // Simulate until $finish, Ctrl-C, or the test program returning
    while (!contextp->gotFinish() && !killed && !sim_done())
    {
        contextp->timeInc(1);

        // Device models tick every cycle; the test program is only resumed once
        // whatever it is blocked on has happened.
        pi_task(top);
        sim_service();

        // Evaluate model
        top->eval();

        tfp->dump(contextp->time());

        if (contextp->time() % 500'000'000 == 0)
        {
            // Break the wavefile
            tfp->close();
            main_time++;
            outpath = std::format("outputs/gps_tb/waveform{}.fst", main_time);
            tfp->open(outpath.c_str());
        }

        if (contextp->time() % 10000000 == 0)
        {
            std::cout << "Simulation time: " << (contextp->time() / 1000000) << " ms" << std::endl;
        }
    }

    // Unwind the test program thread before tearing the model down
    sim_shutdown();

    // Final model cleanup
    top->final();
    tfp->close();

    // Destroy model
    delete top;
    delete tfp;

    // Final simulation summary
    contextp->statsPrintSummary();

    // Return good completion status
    return 0;
}
