griffinross2/Neo-GPS/Simulation/inc/l1ca_code.h

#pragma once

#include <stdint.h>
#include <array>

// Values from IS-GPS-200N, L1CA-PRN-code-assignments-2026-Jan_2.pdf

constexpr uint8_t L1CA_TAPS[37][2] = {
    {2, 6}, {3, 7},  {4, 8},  {5, 9}, {1, 9}, {2, 10}, {1, 8},  {2, 9},  {3, 10}, {2, 3}, {3, 4}, {5, 6}, {6, 7},
    {7, 8}, {8, 9},  {9, 10}, {1, 4}, {2, 5}, {3, 6},  {4, 7},  {5, 8},  {6, 9},  {1, 3}, {4, 6}, {5, 7}, {6, 8},
    {7, 9}, {8, 10}, {1, 6},  {2, 7}, {3, 8}, {4, 9},  {5, 10}, {4, 10}, {1, 7},  {2, 8}, {4, 10}};

constexpr uint16_t L1CA_G2_INIT_38_63[26] = {00017, 00541, 01714, 01151, 01651, 00103, 00543, 01506, 01065,
                                             01564, 01365, 01541, 01327, 01716, 01635, 01002, 01015, 01666,
                                             00177, 01353, 00426, 00227, 00506, 00336, 01333, 01745};

constexpr uint16_t L1CA_G2_INIT_120_210[91] = {
    01106, 01241, 00267, 00232, 01617, 01076, 01764, 00717, 01532, 01250, 00341, 00551, 00520, 01731, 00706, 01216,
    00740, 01007, 00450, 00305, 01653, 01411, 01644, 01312, 01060, 01560, 00035, 00355, 00335, 01254, 01041, 00142,
    01641, 01504, 00751, 01774, 00107, 01153, 01542, 01223, 01702, 00436, 01735, 01662, 01570, 01573, 00201, 00635,
    01737, 01670, 00134, 01224, 01460, 01362, 01654, 00510, 00242, 01142, 01017, 01070, 00501, 00455, 01566, 00215,
    01003, 01454, 01665, 00471, 01750, 00307, 00272, 00764, 01422, 01050, 01607, 01747, 01305, 00540, 01363, 00727,
    00147, 01206, 01045, 00476, 00604, 01757, 01330, 00663, 01436, 00753, 00731};

class L1CACode
{
public:
    L1CACode() = default;
    L1CACode(int sv, int chip_start = 0);

    void clock_chip();
    int get_chip();
    void set_chip(int chip);

    int chip;

private:
    int m_sv;
    std::array<uint8_t, 11> m_g1;  // First bit is space for new bit
    std::array<uint8_t, 11> m_g2;  // First bit is space for new bit
};
