griffinross2/Neo-GPS/(commit log)

2026-05-03 Add kicad projects back and setup verilator simulation
    [GPS_Frontend.csv, GPS_Frontend.kicad_pcb, GPS_Frontend.kicad_sch, sd_card_logger.kicad_pcb, sd_card_logger.kicad_sch]
2026-05-04 Switch the mingw for FST trace files, more reorganization and add spi_tx and l1ca_code generator
2026-05-09 Finish SD card logger PCB and reorganize RTL a bit
    [sd_card_logger.kicad_pcb, sd_card_logger.kicad_sch]
2026-06-13 Further increase logger performance using pre-erase hint ACMD23
    - Seems like the logger no longer overruns the FIFO when logging 1-bit I at 19.2 MSPS
    [sd_host.sv]
2026-08-05 SPI device module and testbench simulating a host in C++
    - Once the actual L1 C/A channel module is implemented, we can use the C++ SPI host to simulate the actual implementation which will consist of a microcontroller connected to the FPGA acting as an SPI host.
2026-08-13 Add in old channel module, access search results over SPI in testbench
2026-08-15 Fix some acquisition issues
    [control_unit.sv, fft_4096.sv, fft_4096_tb.sv, gps_tb.sv, l1ca_ac_pca_search.sv, l1ca_ac_pca_search_tb.sv, l1ca_search_ac_pca.cpp, main.cpp]
2026-08-16 Continue integrating channel and spi infrastructure
2026-08-19 Add ESP32 skeleton and successful HW test of satellite search
2026-08-20 Try to do tracking with ESP32, not working
    - ESP32 might not be accessing spi fast enough. Will check more after moving
    [ephm_l1ca.cpp, filters.cpp, filters.h, gps_if.cpp, gps_if.h, main.cpp, tools.cpp, tools.h]
2026-08-25 Increase ESP32 core speed
2026-08-27 Make ESP SPI faster
2026-08-27 gitignore wasn't added for esp32
2026-08-28 Fix some issues with the ESP32 testing, but its still too slow
    ESP32 misses some epochs and there is nothing the fix it at this point. Will need to wait til the STM32 implementation
    [filters.h, main.cpp, track_l1ca.cpp, track_l1ca.h]
2026-08-28 Start setting up GPS PCB project
    [fpga.kicad_sch, gps.kicad_pcb, gps.kicad_sch, mcu.kicad_sch]
2026-08-29 Add cfg flash to schematic
    [fpga.kicad_sch]
2026-10-08 Major updates to Simulator and hardware
    - Simulator has functional acquisition for L1CA, E1C, B1C, L1C.
    - Simulator can track, decode, and solve for position on L1CA and E1C.
    - Development on custom hardware
    - Created Pi Pico 2 development environment for prototyping.
    [fpga.kicad_sch, frontend.kicad_sch, gps.kicad_sch, mcu.kicad_sch, power.kicad_sch]
2026-10-09 Decouple ephemeris from channel
    Now, navigation data is not cleared when a channel is reset. Instead, navigation data is stored globally and updated whenever new data come in. However, the old data persists even if channels lose lock and are restarted, allowing satellites to be usable again quicker.
    [constants.h, e1_channel.cpp, e1_channel.h, e1_ephemeris.cpp, e1_ephemeris.h, l1ca_channel.cpp, l1ca_channel.h, l1ca_ephemeris.cpp]
2026-10-24 Fix epoch interrupt glitch
2026-10-28 Remove old ESP32 code, update README
